vladimirtier/RFID-Zeiterfassung/IMG_0569.jpg

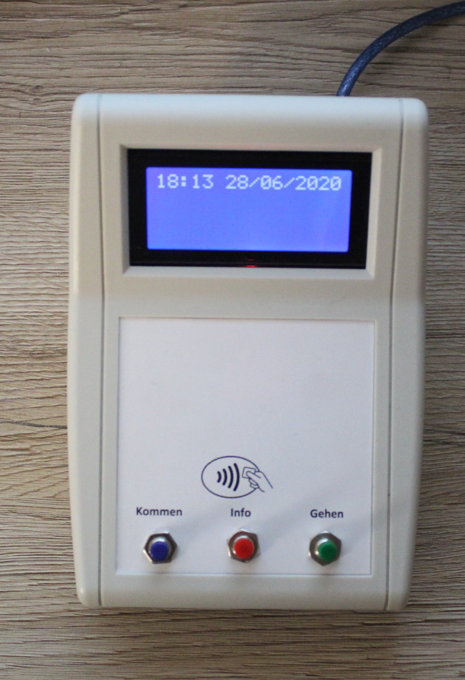
IMG_0569.jpg
