vladimirtier/RFID-Zeiterfassung/circuit_diagram.pdf

3V3

# RST

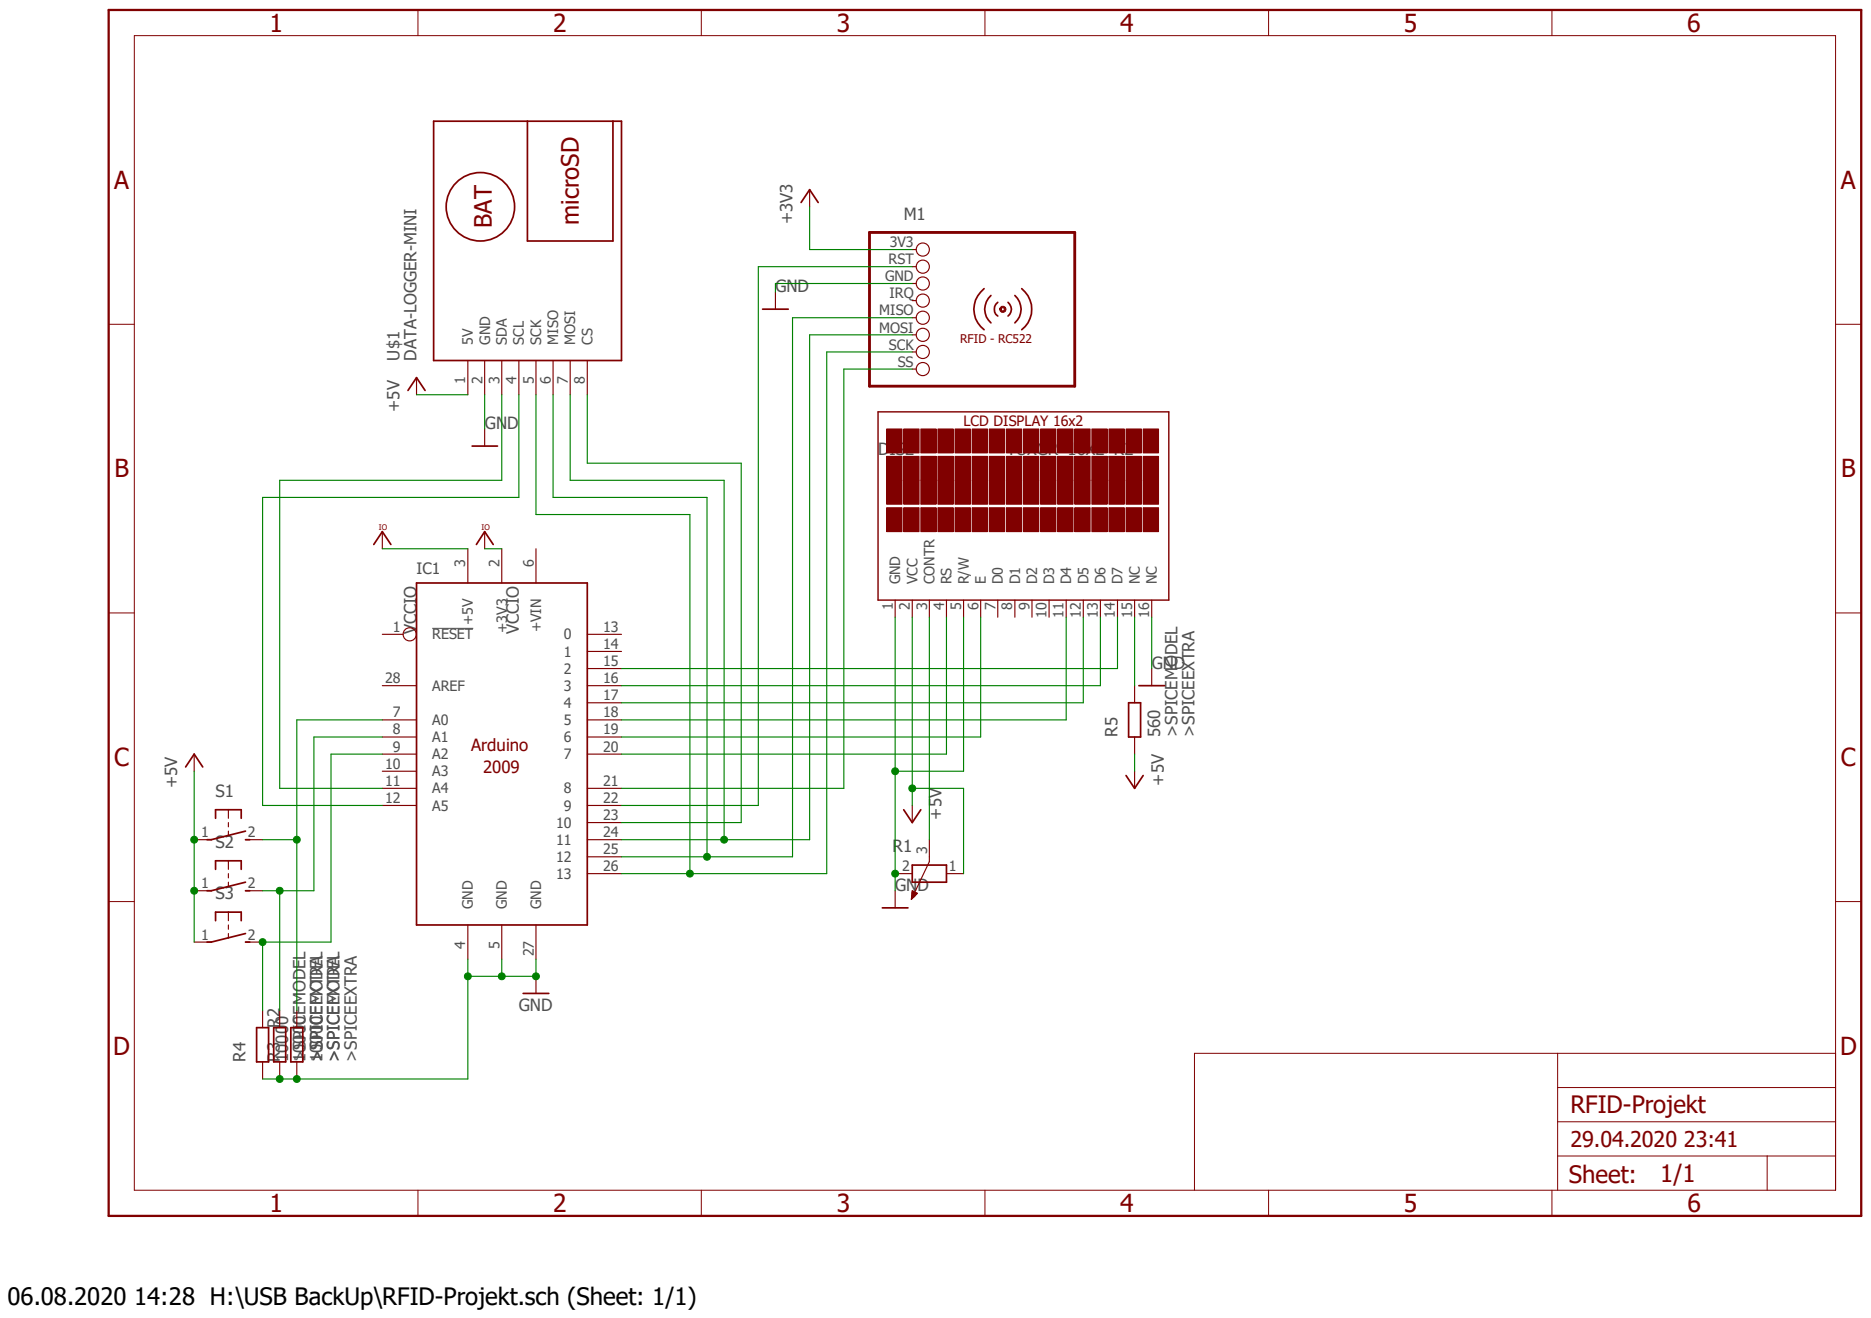
[picture p16: page 1]

17 3
18 4
