vladimirtier/RFID-Zeiterfassung/Struktogramm_Hauptprogramm.pdf

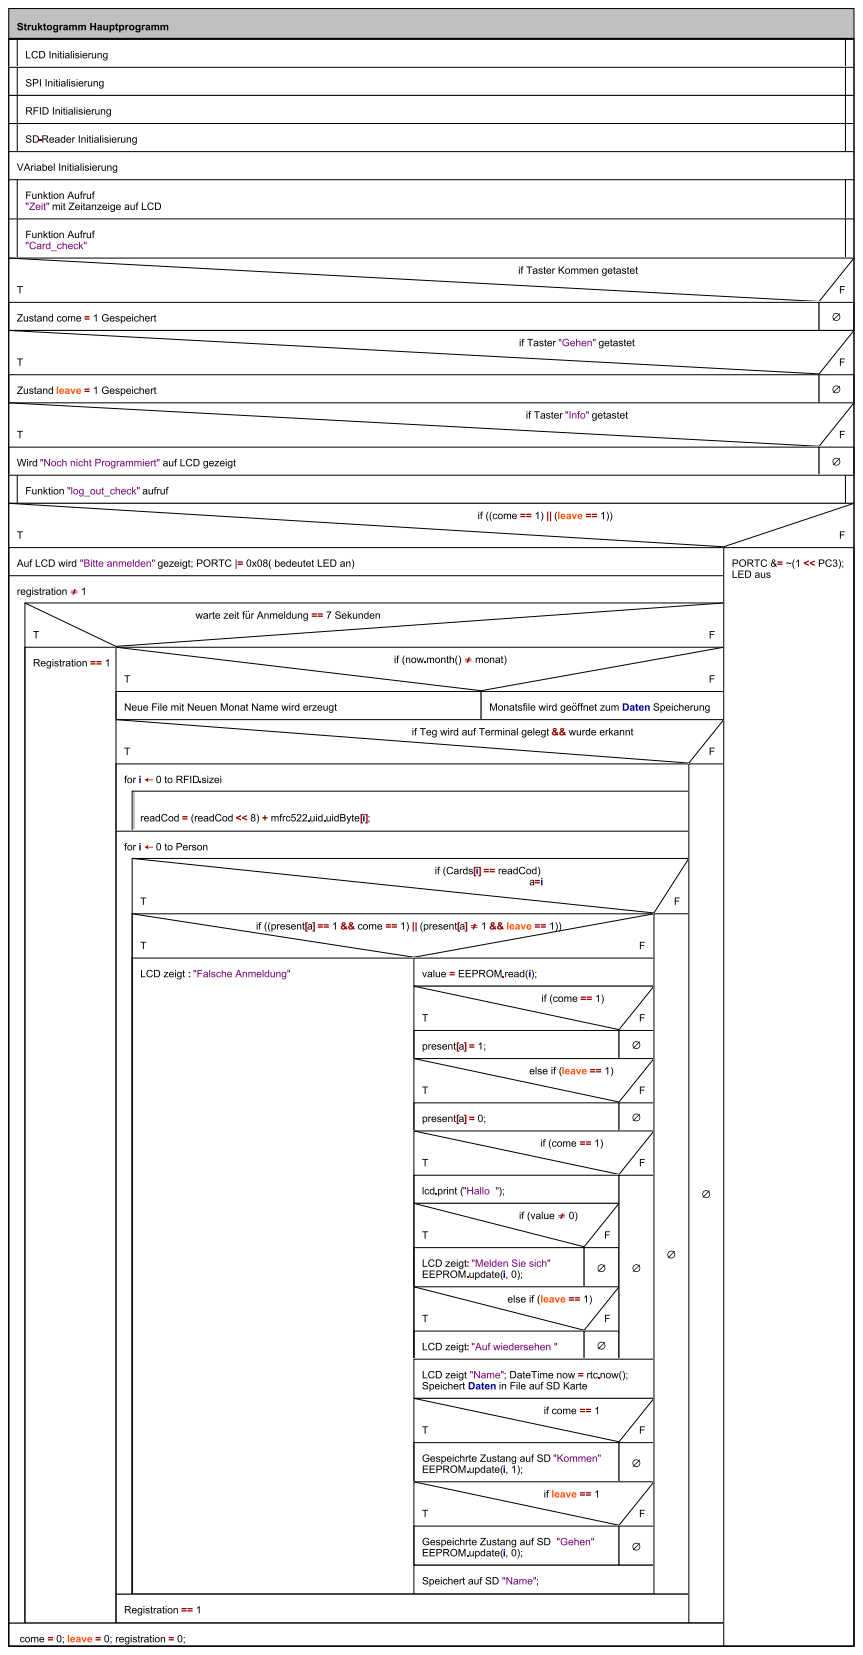
[picture p17: page 1]
