vladimirtier/RFID-Zeiterfassung/RFID-Projekt.sch

## EAGLE design RFID-Projekt.sch (2020-08-06, last stored version)

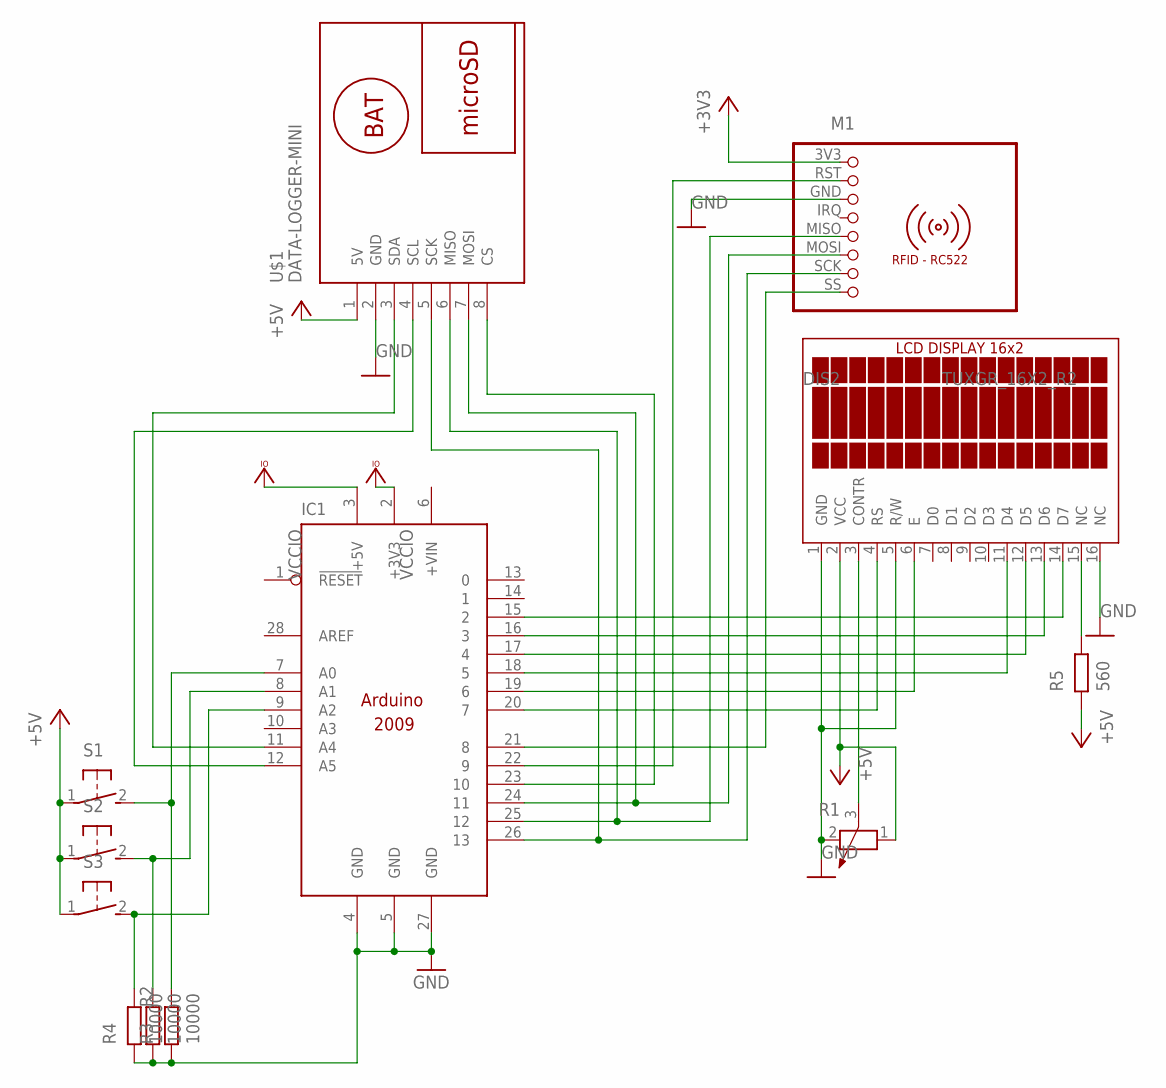
[picture p18: schematic RFID-Projekt.sch]

Parts:
DIS2: TUXGR_16X2_R2
IC1: ARDUINO2009_10; ARDUINO2009
M1: RFID-RC522
R1: POTENTIOMETER_PT-10; PT-10
S1, S2, S3: 31-XX; B3F-31XX
U$1: DATA-LOGGER-MINI

Connections:
+3V3: M1.3V3 (1)
+5V: DIS2.2 (VCC), R1.1, S1.1, S2.1, S3.1, U$1.1 (5V)
GND: DIS2.1 (GND), DIS2.5 (R/W), DIS2.16 (NC), IC1.4 (GND), IC1.5 (GND), IC1.27 (GND), M1.GND (3), R1.2, U$1.2 (GND)
unnamed: IC1.12 (A5), U$1.4 (SCL)
unnamed: IC1.11 (A4), U$1.3 (SDA)
unnamed: IC1.25 (12), M1.MISO (5), U$1.6 (MISO)
unnamed: IC1.24 (11), M1.MOSI (6), U$1.7 (MOSI)
unnamed: IC1.26 (13), M1.SCK (7), U$1.5 (SCK)
unnamed: IC1.23 (10), U$1.8 (CS)
unnamed: IC1.8 (A1), S2.2 (S)
unnamed: IC1.7 (A0), S1.2 (S)
unnamed: IC1.9 (A2), S3.2 (S)
unnamed: IC1.22 (9), M1.RST (2)
unnamed: IC1.21 (8), M1.SS (8)
unnamed: DIS2.3 (CONTR), R1.3
unnamed: DIS2.12 (D5), IC1.17 (4)
unnamed: DIS2.11 (D4), IC1.18 (5)
unnamed: DIS2.13 (D6), IC1.16 (3)
unnamed: DIS2.14 (D7), IC1.15 (2)
unnamed: DIS2.6 (E), IC1.19 (6)
unnamed: DIS2.4 (RS), IC1.20 (7)
VCCIO: IC1.2 (+3V3), IC1.3 (+5V)
